MatveiMKS/Le-Dealos/README.md

# Le Dealos (projet arduino peip2)

## <ins>Cahier des charges</ins>

## I. <ins>Contexte et réalisation du problème</ins>
Lors de diverses soirées jeux de société durant lesquelles nous souhaitions jouer au BlackJack, nous avons été confrontés au problème de devoir sacrifier un joueur pour qu’il prenne le rôle du croupier.
Problème : Ne pas pas avoir de croupier dedié au BlackJack.

## II. <ins>Objectif et périmètre du projet</ins>
Réaliser un robot permettant de remplacer un croupier de BlackJack
Pour cela il devra pouvoir accomplir les tâches suivantes :
- Distribuer des cartes à un nombre donné de joueur (entre 1 et 4)
- Distribuer les cartes du croupier
- Lire la valeur de chaque carte distribuée
- Gérer la partie, le score et le gagnant
- Afficher les actions à effectuer
- Afficher le status de la partie

Fonctionnalités envisageables :
- Gérer le système de paris
- Ajouter des instructions vocales
- Un algorithme de poker
