MatveiMKS/Le-Dealos/Rapports séances/Maksimenka Matvei/rapport8.md

# Rapport de séance 8 du 21/02/2024

## Montage de l'écran
Cette séance ma principale mission était d'attacher l'écran et les boutons au projet.
Pour cela j'ai tout d'abord créé un designer a découper a la decoupe laser, mais je me suis trompé sur la manière de monter l'écran. Une fois un nouveau design conçu, j'ai pu le découper. Je comptais initialement monter la plaque à l'aide de coudes mais il n'y en avait que des trop gros. J'ai donc décidé de coincer la plaque entre les deux disques fixes entre lesquels se trouve toute l'électronique, mais le montage que j'avais prévu n'étais pas assez haut, je suis donc retourné sur inkscape et ai adapté la taille.

## Réhaussement de la plateforme
En prenant en compte tous les branchements nécessaires pour le projet je me suis rendu compte qu'il me faudra plus de place afin d'ajouter une plaque de distribution et faire passer plus de fils. J'ai donc ajouté des entretoises à chaque support et ai dû donc prendre de plus longue vis.

<p align="middle">
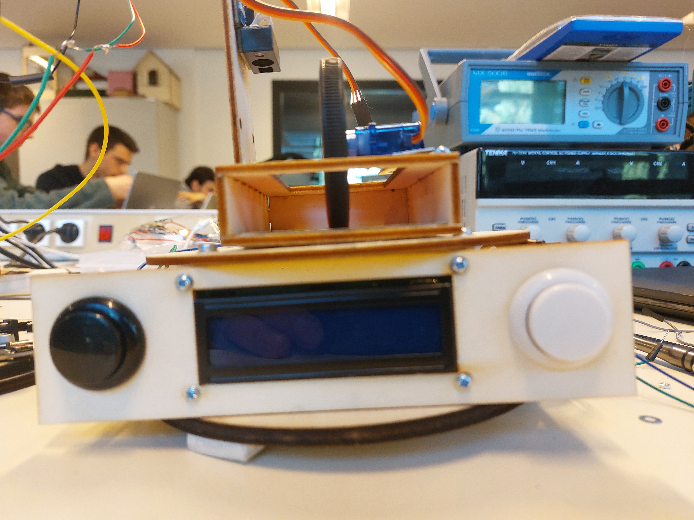
[picture p1: Images Diverses/ecran monte.jpg]
    
    
</p>
