MatveiMKS/Le-Dealos/Rapports séances/Maksimenka Matvei/rapports.md

# Rapport de séance du 14/02/24

## Changement de direction 
Nous avons reçus un nouveau capteur de QR code mais pour éviter le Burnout, nous avons échangé de tâches avec Théophile, je me suis donc mit au montage du projet.

En premier lieu j'ai collé deux patins en PVC sour le disque du dessus afin de pouvoir une mouvement circulaire fluide.

Ensuite j'ai monté l'arduino et le contrôleur pour le servo moteur sur le disque du dessus, pour cela je suis allé chercher des vis et boulons de la longueur nécessaire puis j'ai percé 8 trou dans le bois.

J'ai donc pu attacher les 2 cartes, pour que il n'y ait pas de câbles qui sortent sur les côtés je les ait fixé avec du gaffeur à l'intérieur.

Finalement j'ai pu tout mettre ensemble et ont voit enfin à quoi ça ressembler notre projet.

Je me suis aussi rendu compte que on n'allait pas avoir assez de sortie 5v et gnd j'ai donc soudé des fils ensemble pour faire des séparateurs.
