MatveiMKS/Le-Dealos/Rapports séances/Maksimenka Matvei/rapport6.md

# Rapport de séance 6 du 07/02/2024

## Les problèmes
Après la dernière séance où je n'ai pas réussit à faire fonctionner le qr code nous avons conclus que je l'qvais surement grillé en inversement les branchements. J'ai du donc faire la décision d'abandonner le travail sur le lecteur pour le moment on en commandera peut être un autre.

## La plateforme
J'ai décidé de continuer la séance en créant la plateforme surélevée qui contient la partie qui distribue les cartes. Je me suis d'abbord penché sur la manière de la hauteur. En m'inspirant du projet Robot de Surveillance j'ai pris de longues entretoises que j'ai vissé entre les deux plaques de bois. J'avais besoin de visses de +-10mm mais il n'y en avait plus j'ai du donc couper des vis de 20mm à la pince. J'ai enfin pu tout mettre ensemble et on commence à voir la forme entière du projet.

<p align="middle">
    
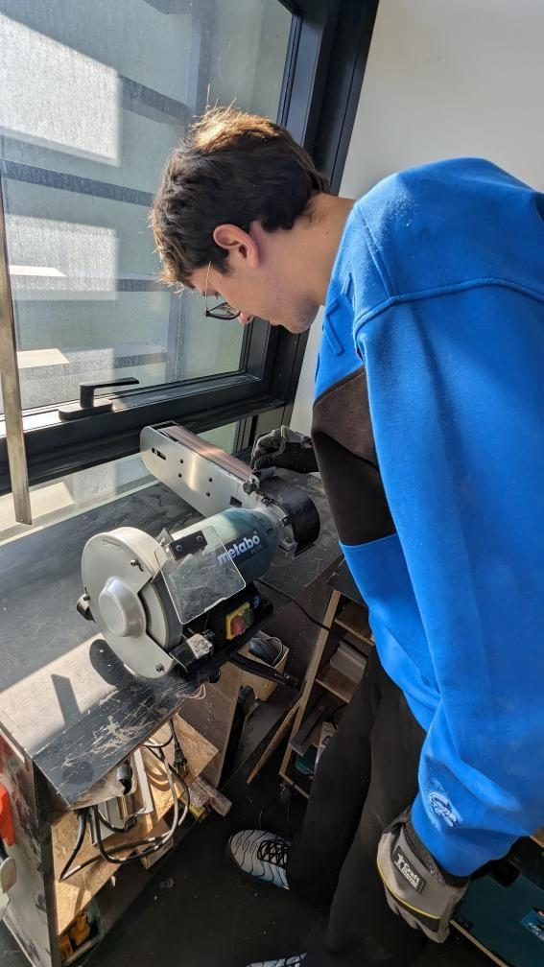
[picture p4: Images Diverses/cv te meuler.jpg]
    
</p>
