MatveiMKS/Le-Dealos/Rapports séances/Di Bona Théophile/rapport6.md

# Rapport de séance 6

## Finalisation du support rotatif 

J'ai finalement choisit d'opter pour la version du support rotatif avec un axe au milieu pour maintenir le tout.
J'ai commencer par réaliser une plaque ronde en bois pour fixer la roue cranté. J'ai percé le milieu de la plaque en bois pour y placer l'axe.

J'ai ensuite trouvé le milieu de la plaque sur laquelle est placé le moteur à l'aide d'un compas, puis j'ai percé celui-ci pour y faire passer l'axe 
J'ai assemblé le tout et lancé le tout et cela à fonctionné ! Enfin ! J'en ai profité pour visser le tout pour un fonctionnement optimal.

Cependant, le poids de la plaque faisait que l'extrémité à l'opposé du moteur touchait le roue cranté en plus de donné un rendu visuel moyen.
M Juan m'a donc proposé une tige de PVC dans laquelle j'ai pu découper quelques morceaux afin de m'en servir de calle et ainsi d'éviter le frottement.
J'ai collé ceux si sur la plaque de bois portant le moteur. Cela à bien fonctionner cependant j'ai perdu en fluidité de rotation. 

J'ai ensuite aidé Mateï pour le design de la plaque destiné à acceuillir les composants électroniques (carte arduino, driver, ....). Nous sommes parti du 
même modèle que les autre plaques rondes cependant nous avons prévu des emplacements pour le vis afin d'y placer des entretoises.
Nous avons monté le tout et nous sommes arrivé à ce resultats final.

## Objectifs pour la prochaine séance

Relier les boutons au tout, pour se rapprocher le plus possible de la fin de notre projet. Nous allons aussi commander un autre capteur car celui que nous avons est dysfonctionnel.
