MatveiMKS/Le-Dealos/Rapports séances/Di Bona Théophile/rapport5.md

# Rapport de séance 5

## Conception du support rotatif

Pour cette 4ème séance, j'ai commencé par finaliser mon esquisse 2D du sopport rotatif sur inskape. J'ai corrigé la taille de la fente prévue pour accueillir 
le moteur et réaliser deux trous de part et d'autres de la fente afin d'accueillir des vis permettant de fixer le moteur sur le contreplaqué.

Avant d'aller au FabLab pour réaliser la découpe, j'ai fait la démonstration et l'explication de notre projets aux lycéens venus pour découvrir notre école.
J'ai aussi profiter de ce temps pour répondre à leurs question sur l'école.

Une fois cette découpe réalisée, j'ai fixé mon moteur sur ce support à l'aide de vis et d'écrous que j'ai pu glisser dans les trous prévu à cet effet.
J'en ai aussi profité pour collé le pignon réaliser lors de la dernière séance au moteur pas à pas.

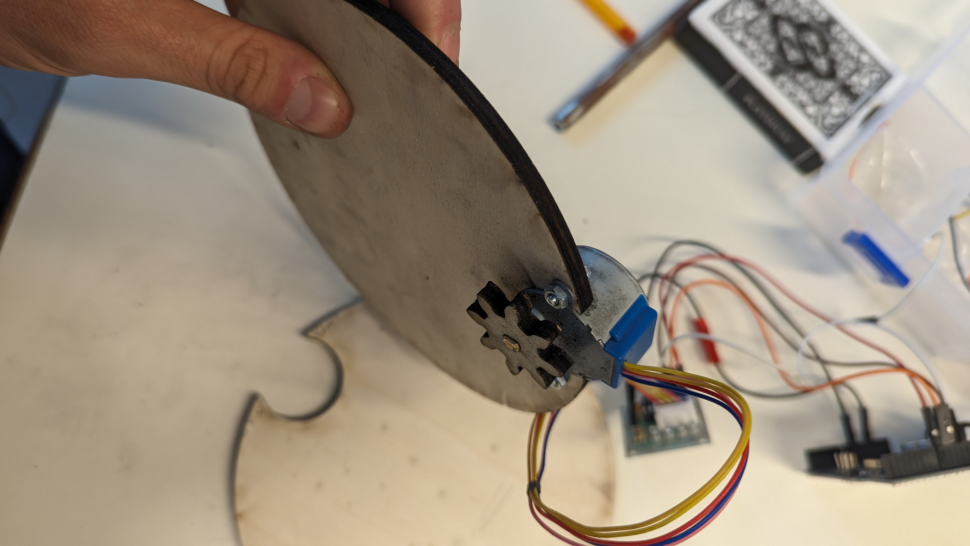
[picture p8: Images Diverses/fixation_moteur.jpg]


J'ai ensuite commencé l'assemblage du support rotatif et j'ai toute de suite fait face à un premier problème, celui-ci n'etait pas équilibré. 
J'ai donc tenté de mettre une punaise en-dessous du support pour le remettre à niveau cependant mon moteur deviait de sa trajectoire. J'ai donc 
réflechit à une autre option pour ajuster cela. J'ai choisit de réaliser un autre écrou qui serait fixé à l'opposé du moteur qui aurait pour fonction de 
bloquer la trajectoire de la partie rotative. J'ai donc réaliser un deuxième écrou avec un trou au milieu afin qu'il puisse acceuillir une tige autour de laquelle il tournerait. Encore une découpe au FabLaB pour ce deuxième écrou. J'ai ensuite été percer ma plaque rotative pour venir glisser la tige à l'intérieur.
J'ai tout assemblé mais malheureusement le moteur se bloquait comme s'il n'avait pas assez de couple pour entrainer ce 2ème écrou.

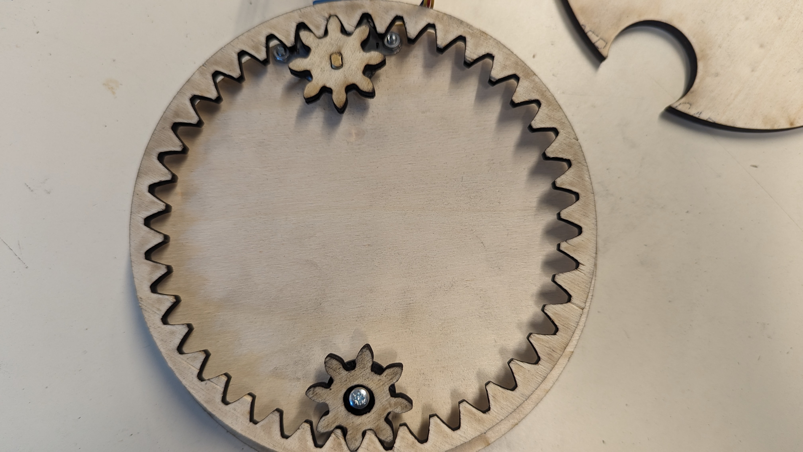
[picture p9: Images Diverses/rotation_double_pignon.jpg]


En 3ème option, j'ai choisit de mettre un axe métallique au milieu du support afin d'être sur que ça dévie pas de la trajectoire. Je pensais y placer un roulement à bille pour faciliter la rotation cependant après m'être concerter avec les professeurs un axe metallique seul devrait suffir.
Cependant, je n'ai pas le temps de réaliser cette dernière option.

## Bilan

Malheursement, j'ai encore peu avancé durant cette séance et je commence à prendre beaucoup de retard sur la conception du support rotatif. J'espère vraiment le finir durant la séance prochaine pour venir aider Matveï sur le lecteur de QR code. Quitte à change de système avec un engrenage placé à l'extérieur du système.
Malgré le fait que cet option est bien moins ergonomique.
