MatveiMKS/Le-Dealos/Rapports séances/Di Bona Théophile/rapport4.md

# Rapport de scéance 4

## Réalisation du support rotatif 

J'ai commencé cette séance par étudier le fonctionnement du moteur pas à pas puis réaliser un programme afin de faire fonctionner le moteur

J'ai ensuite modélisé un nouvel engrenage afin de pouvoir le fixer sur le moteur car celui que j'avais réaliser précedemment n'était pas adapté. 
Puis j'ai été le découper au Fab Lab mon engrenage dans du contreplaqué de 5mm. J'ai réaliser les premiers test avec la roue crantée fabriqué lors de la 
séance précédente. Cela fonctionnait bien cependant j'ai peur qu'une fois le système fini le couple ne soit pas assez puissant pour faire tourner tout le système.

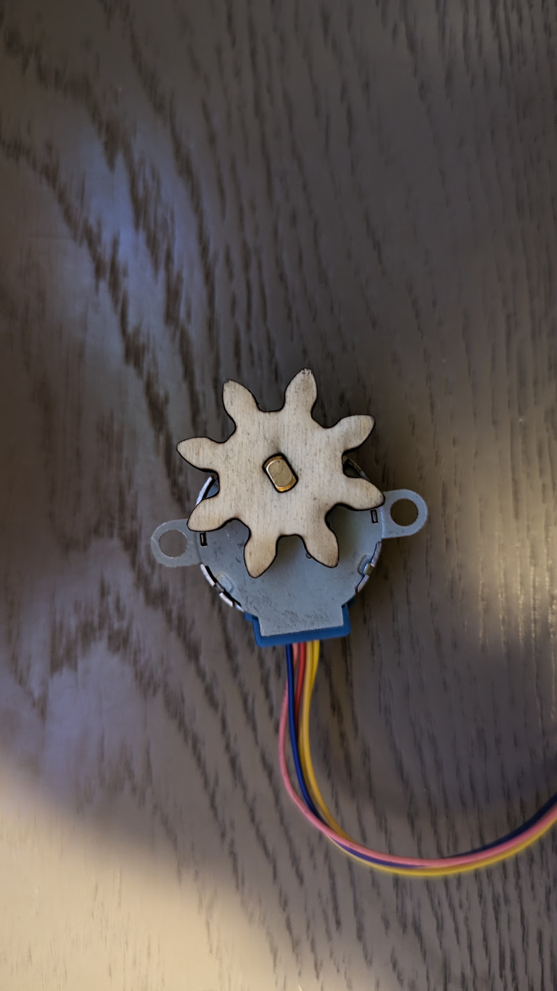
[picture p10: Images Diverses/moteur_engrenage.jpg]


J'ai ensuite réaliser sur inkscape la pièce qui prendra place au dessus du moteur sur laquelle tout le reste du système sera placé.
Pour cela j'ai tracé un cercle du diamètre de la roue crantée avec un creux en arc de cercle sur une extrémité pour venir accueillir le moteur.

J'ai ensuité été découper cette pièce au Fab Lab dans du contre plaqué de 5mm. Malheureusement au moins d'agrandir mon cercle je n'ai pas conservé la taille de 
l'encoche pour le moteur. Donc au moment d'assembler les pièces, les trous permettant de fixer le moteur étaient dans le vide. J'ai donc du réaliser une autre 
pièce dans les bonnes dimension. J'en ai aussi profiter pour faire les trous pour les vis pour ne pas avoir à repercer dans le contreplaquer et risquer de briser le bois.

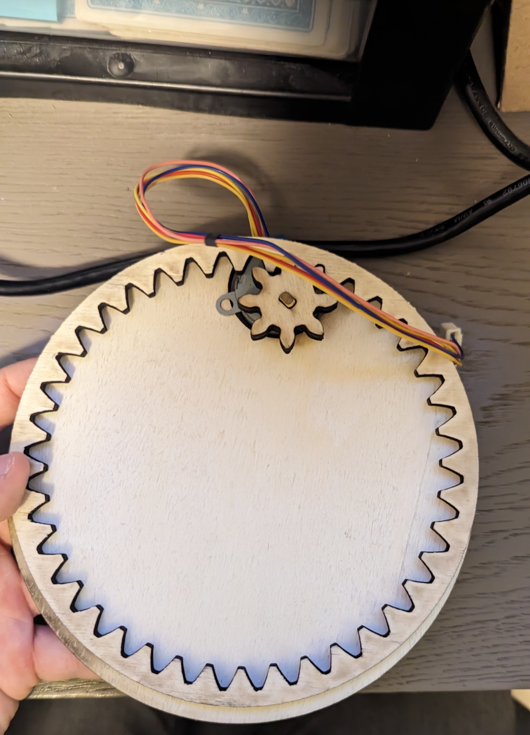
[picture p11: Images Diverses/systeme_rotatif_v1.jpg]


## Objectif pour la semaine prochaine 

Finir le support rotatif et débuter la lecture des QR codes.
