MatveiMKS/Le-Dealos/Rapports séances/Maksimenka Matvei/rapport4.md

# Rapport de séance 4 du 17/01/2024

## Interaction homme machine (suite)
Durant cette séance j'ai pris le temps de revoir mon code afin de le rendre plus clair et robuste en enlevant des tests et boucles inutiles.
J'ai ensuite commencé à créer le jeu lui-même, pour cela je fait distribuer deux cartes a tout les joueurs et au croupier.
J'ai ensuite fait des recherches afin d'implémenter la possibilité pour le programme de savoir qui a gagné en considérant les cartes de tous les joueurs. Pour cela je suis d'abord parti sur la piste d'un dictionnaire ou les clés seraient les joueurs et les valeurs leurs cartes mais cela paraissait trop compliqué sur arduino car cela occupe trop de place sur l'arduino.
Je vais donc plutôt créer une liste de liste avec 4 éléments car il y a au maximum 4 joueurs.

Malheureusement je n'ai pas de photos pour cette séance car il n'y avait pas grand chose à montrer. Je suis tout de même content car je vois que le code est bien avancé.
