MatveiMKS/Le-Dealos/Rapports séances/Di Bona Théophile/rapport3.md

# Rapport de séance 3

## Réalisation du support rotatif 

J'ai commencé la séance par me questionner quant à la réalisation du support rotatif. J'ai opté pour un système d'engrenage qui serait placé en-dessous 
le système de distribution. Il y aurait une grande roue dentée ouverte fixe dans laquelle une autre roue denté entrainée par un moteur tournerait à l'intérieur
de cette roue pour faire tourner tout le système.

Cependant, j'ai perdu beaucoup de temps sur la réalisation de ces engrenages. En effet, presque aucun logiciel ne propose une aide à la modélisation en 3 dimension
pour ce type d'engrenage. J'ai finalement trouvé un site web permettant de les modéliser et de les exporter au format SVG. J'ai donc voulu dans un premier temps 
importer ce fichier SVG dans OnShape (Logiciel de modélisation 3D) comme esquisse pour ensuite l'extruder. Au final, après concertation avec les encadrants,
j'ai choisis de réaliser ces engrenages en bois.

J'ai donc adaptée la roue motrice afin de pouvoir la fixer au moteur. Puis j'ai découpé ces engrenages dans une plaque de bois de 5mm. J'ai poncé l'exterieur de 
la roue fixe pour un meilleur rendu. Puis j'ai collé la rondelle fournie dans la boite du moteur sur le petit engrenage.

J'ai ensuite réaliser un programme pour voir si ce système fonctionnait. Cependant le servo-moteur qui nous avait été fourni n'était pas à rotation continue
il pouvait seulement tourner sur un angle de 270°. J'ai donc demandé un autre moteur à rotation continue cependant celui qui m'a été donné pouvait seulement 
effectuer une rotation de 180°. 

Pour la prochaine séance, prendrais un moteur pas à pas cela sera plus simple, n'utilisant les autres fonctions du servo-moteur

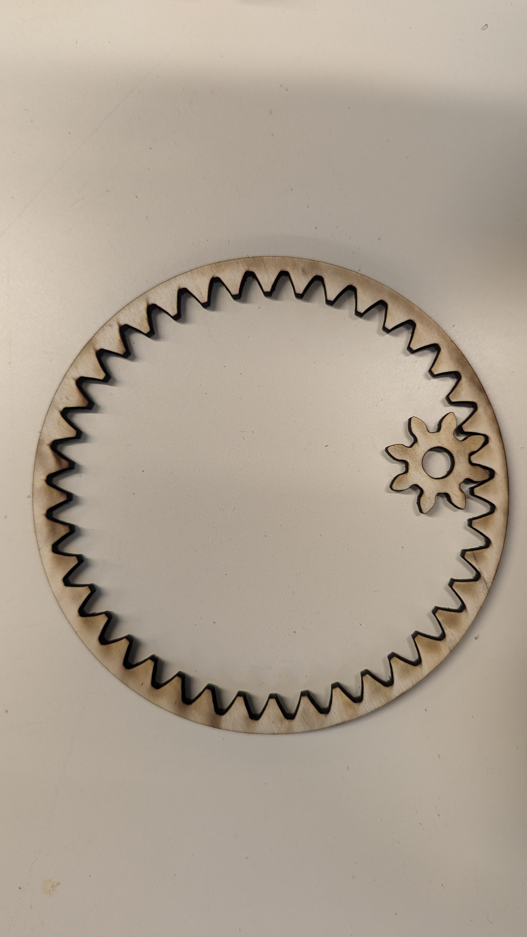
[picture p13: Images Diverses/engrenage_support.jpg]
support


## Bilan 

J'ai peu avancé durant cette séance, j'espère pouvoir être plus productif durant la prochaine séance et finir si possible le support
