MatveiMKS/Le-Dealos/Rapports séances/Maksimenka Matvei/rapport2.md

# Rapport de séance 2 du 20/12/2023

## Branchement des 4 boutons
J'ai pu cette semaine faire le branchement des 4 boutons dont on aura besoin pour interagir avec notre robot.
<p align="middle">
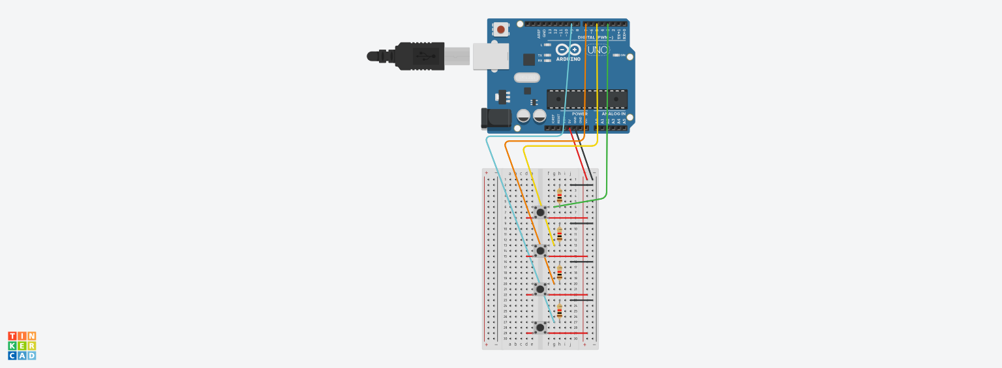
[picture p14: Images Diverses/boutons montage.png]
    
     
</p>

## Code pour les boutons
Je me suis ensuite occupé du code qui détecte quel bouton a été appuyé en dernier et fait en sorte qu'on ait plus qu'à ajouter sa fonction (simulé par l'affichage du mot action).

<p align="middle">
    
     
</p>
<p align="middle">
    <a>Demande d'interaction</a>
    <a>-------------------</a>
    <a>Affichage de l'action</a>
</p>

## Conclusion de la séance
J'ai maintenant la base qui me permettra de piloter tout le projet, il faut maintenant que je relie le code a la partie de Théophile afin que l'on puisse se faire distribuer une carte en appuyant sur un bouton.
