MatveiMKS/Le-Dealos/Rapports séances/Di Bona Théophile/rapport2.md

# Rapport de séance 2

## Creation du support de carte 

J'ai commencé cette séance par découper sur une plaque de bois de 3mm le support pour les cartes.

J'ai agrandi le creux sur la surface haute de la boite afin de m'assurer que le lecteur de code bar puisse lire la valeur de la carte.

Une fois le support découpé je l'ai assemblé puis collé avec de colle à bois pour assurer une meilleur rigidité. J'ai donc obtenu le résultat suivant :

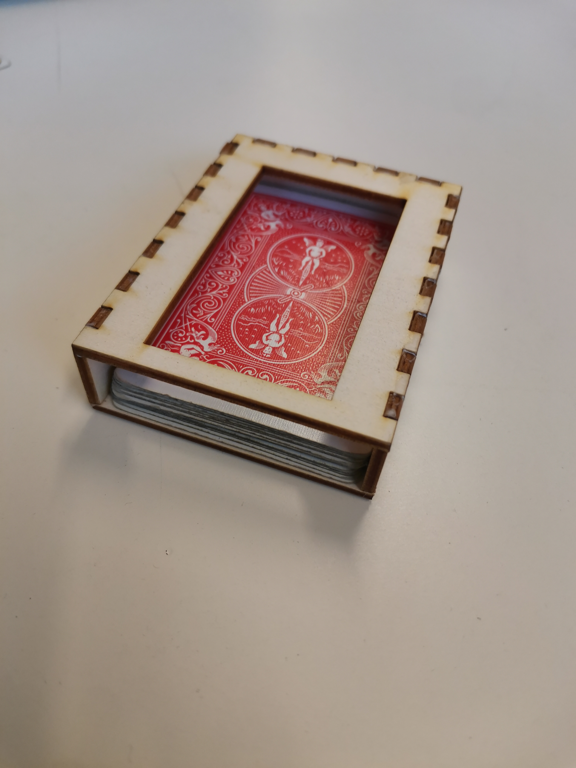
[picture p15: Images Diverses/support_carte_assemble.jpg]
support


## Ajout du moteur sur le support 
Puis j'ai réflechis et comparé les différents système pour la fixation du moteur sur le support. J'ai finalement opté pour un système de charnière fixé sur le 
coté du support. Le moteur se colle au carte grâce à son poids et descend petit à petit au fur et à mesure que les cartes sont distribuées.
Le bois du support étant peu épais, j'ai fixé la charnière au support et le moteur à la charnière à l'aide d'un pisolet à colle.

J'ai ensuite adapté les temps et puissance de moteur sur le programme arduino afin de ne distribuer qu'une seule carte à la fois. 
J'obtiens donc le resultat suivant : 

fonctionnement

Parfois deux cartes sont à distribuées en une seule fois, je pense que cela est lié au fait que les cartes ne sont pas plastifiées donc celle-ci s'accrochent 
entre elles. Nous opterons ainsi pour une jeu de bicycle plastifié comme ceux utilisé en magie ou au poker.

Sur cette fin de séance, nous avons essayer de lier nos travaux avec Matveï de façon à ce qu'une carte soit distribuée lorsque l'on appuie sur le bouton "Tirer".
Cependant cela à causé de nombreux bugs, l'écran ne s'allumait pas et le moteur ne fonctionnait pas non plus. Cela est surement dû au fait que nous étions en fin de séance et nous n'avons pas pris le temps de bien faire les branchements. Nous allons donc profiter des vacances pour faire cela !

En conclusion, j'ai réussi à accomplir le premier objecif sur le temps que nous nous étions donné. 

## Objectif pour la séance suivante
Ayant fini cette première partie, je vais pouvoir me lancer sur l'affichage écran des différents statuts de jeux. Etant donné que les écrans LCD semblent petit peut être utiliser un écran plus grand.
