MatveiMKS/Le-Dealos/Rapports séances/Maksimenka Matvei/rapport1.md

# Rapport de séance 1 du 13/12/2023

## Résolution de problème d'IDE
Lors du démarrage du projet, je me suis rendu compte que mon IDE était mal installé et nous  n'avons pas trouvé de solution je serais donc obligé d'aller visiter le bureau de 
Sans moyen d'utiliser ma carte arduino je suis obligé de passer au prototypage.

## Soudure des boutons
Les bontons n'ayant pas de fils au bout, j'ait soudé des fils avec des embouts males pour les connecter sur l'Arduino. Je les ait ensuite testés pour vérifier que j'ai bien soudé pour enfin mettre du gaffeur pour eviter les courts circuits ou que les soudures cassent.

<p align="middle">
    
     
</p>
<p align="middle">
    <a>Soudure d'un bouton</a>
    <a>-------------------</a>
    <a>Test de l'un des boutons</a>
</p>

## Conclusion de la séance
Je n'ai malheureusement pas pu avancer aussi loin que je voulais en raisons de mes problèmes ordinateur qui ne sont tout de même pas résolus, j'espère rattraper le rythme a la prochaine séance.
