MatveiMKS/Le-Dealos/Rapports séances/Di Bona Théophile/rapport1.md

# Rapport de séance 1
## Creation du support de carte 
Creation d'une boite sur Makercase aux dimension d'un paquet de carte Bicycle classique.

Edition de la face du haut de cette boite à l'aide du logiciel Inkscape.

La fente créée permettra que la roue soit en contact avec les cartes 
afin de les distribuer. 

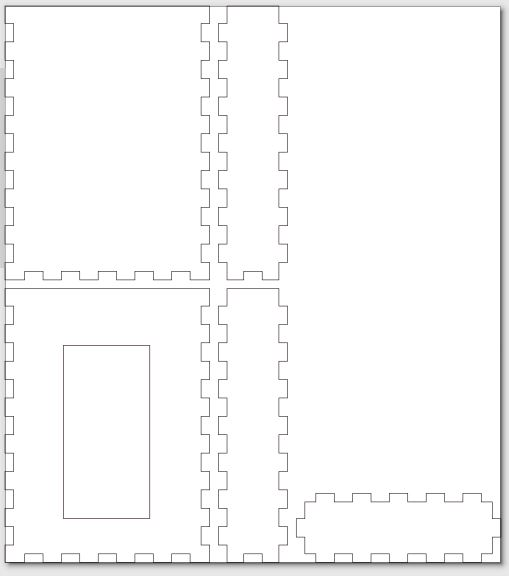
[picture p18: Images Diverses/capture_support_carte.JPG]
Plan de découpe


Nous pourrons réaliser la découpe la semaine prochaine.

## Essai et création d'une programme pour le Servomoteur SG90
Réalisation d'un programme permettant de distribuer une carte à la fois.

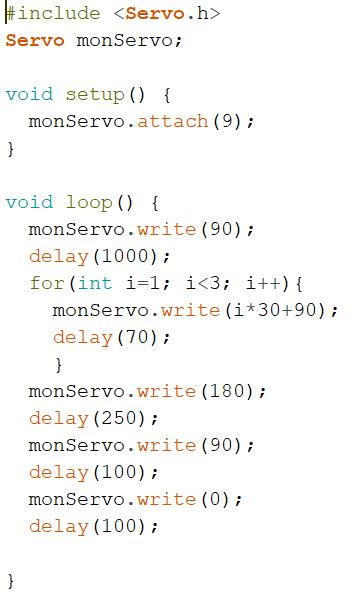
[picture p19: Images Diverses/programme_distribution_v1.JPG]
Programme distribution

Première tentative distribution de carte


J'ai constaté qu'il va être compliqué de gérer la pression de la roue sur les cartes.

Nous allons donc devoir utiliser un élastique ou bien un ressort pour adapter la pression en fonction du nombre de cartes restantes.

Cela m'a aussi fait me questionner sur l'idée d'agrandir la fente car lorsque la roue est positionnée sur l'avant de la carte,

la distribution des cartes une par une 
est mieux gérée. De plus les cartes vont plus loins.

Nous pensons aussi qu'il faudra rajouter une petit rampe pour faire en sorte que les cartes aillent plus loin.  
lien d'une image

## Objectif pour la semaine suivante 
Réaliser la découpe laser du support 

Réaliser le montage du système moteur et support 

  Sytème de charnière pour faire le tenir le moteur equipé d'un ressort pour maintenir une pression constante
