MatveiMKS/Le-Dealos/Rapports séances/Di Bona Théophile/rapport0.md

# Rapport de séance 0

## Tâche effectuée
Description de la tâche

lien d'une image
