MatveiMKS/Le-Dealos/(commit log)

2023-12-13 ajt les objectifs au rapport
2023-12-20 support carte assemblé
