MatveiMKS/Le-Dealos/Images Diverses/ecran arriere.jpg

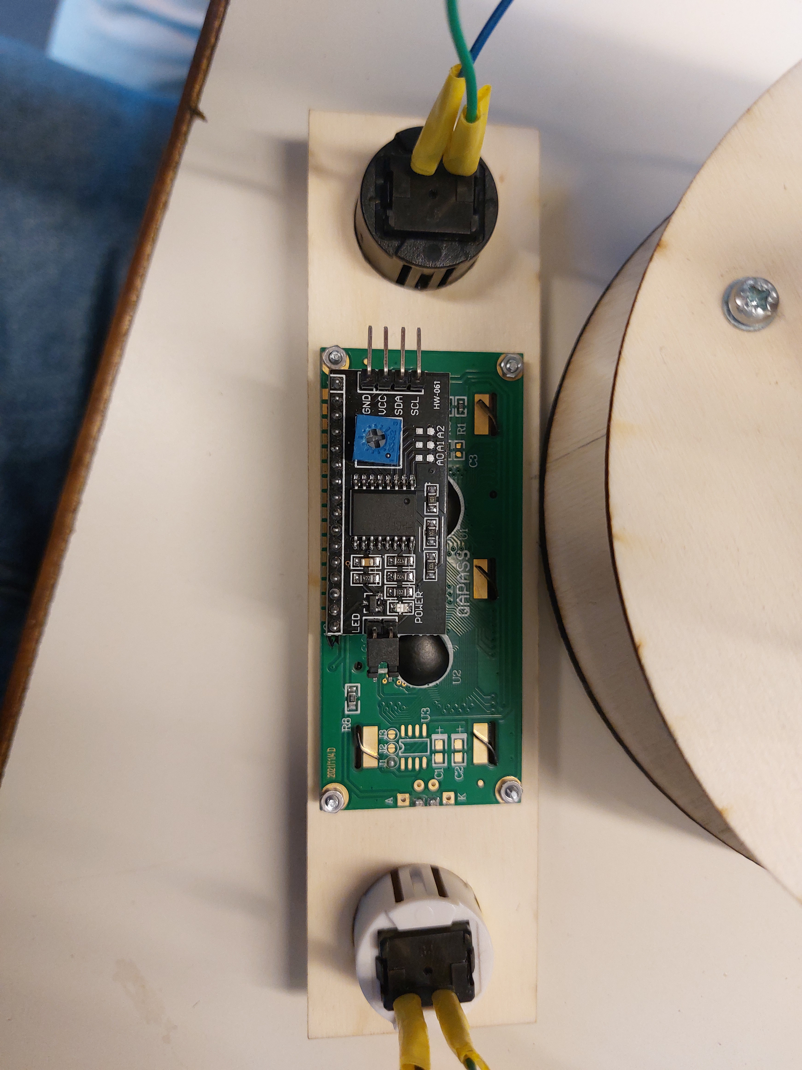
[picture p2: Images Diverses/ecran arriere.jpg]
Images Diverses/ecran arriere.jpg
