MatveiMKS/Le-Dealos/Images Diverses/2 plaques.jpg

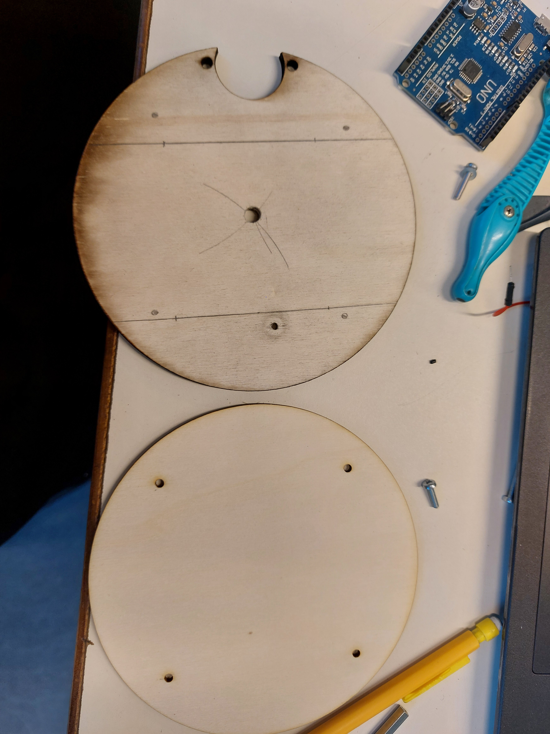
[picture p3: Images Diverses/2 plaques.jpg]
Images Diverses/2 plaques.jpg
