MatveiMKS/Le-Dealos/Images Diverses/soudure lecteur.jpg

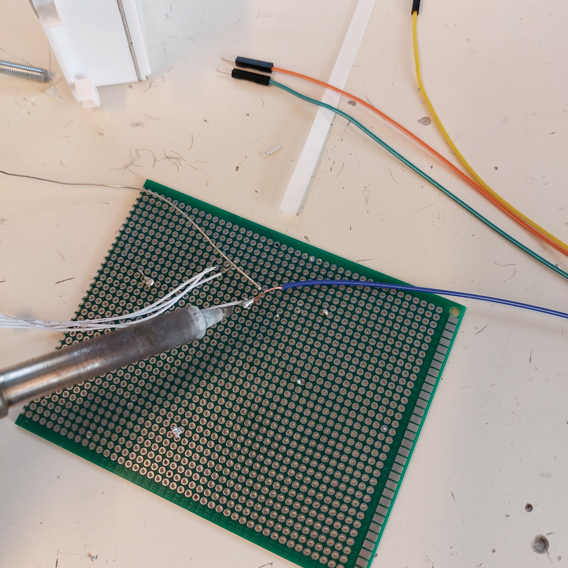
[picture p5: Images Diverses/soudure lecteur.jpg]
Images Diverses/soudure lecteur.jpg
