MatveiMKS/Le-Dealos/Images Diverses/20231213_115449.jpg

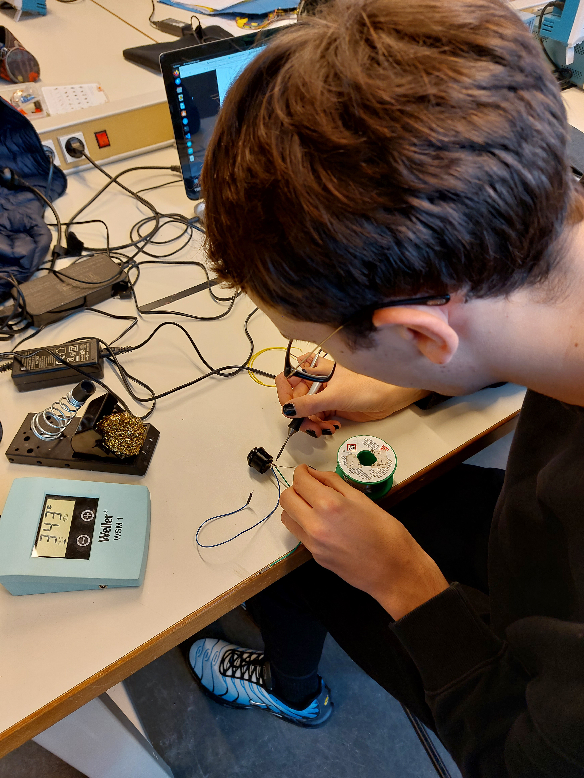
[picture p16: Images Diverses/20231213_115449.jpg]
Images Diverses/20231213_115449.jpg
