MatveiMKS/Le-Dealos/Images Diverses/20231213_121834.jpg

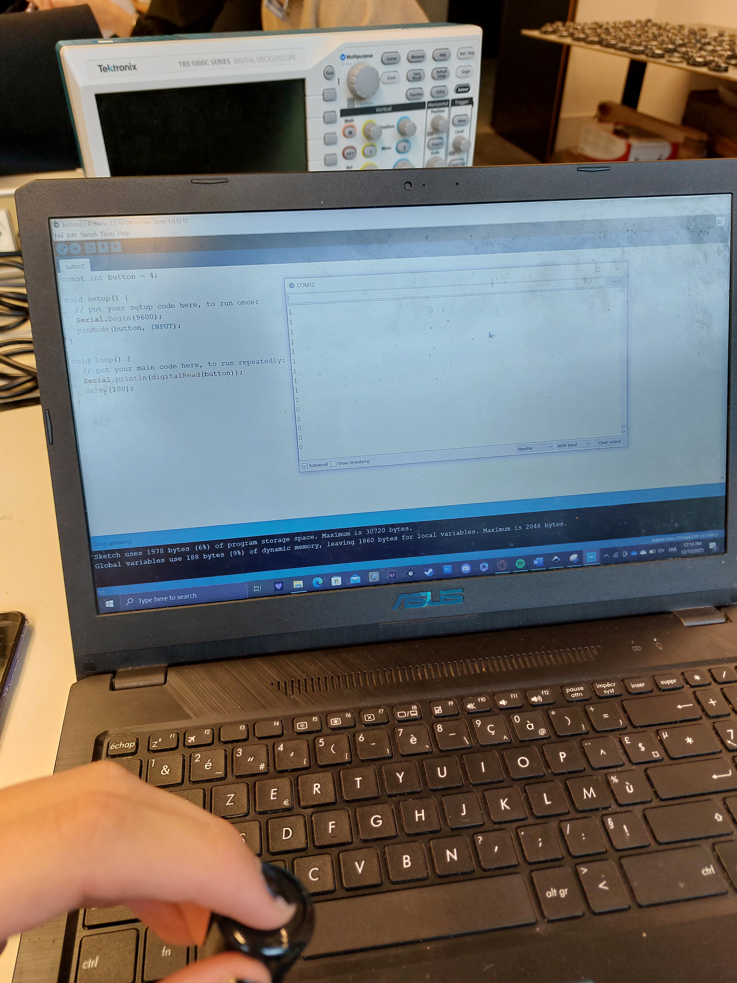
[picture p17: Images Diverses/20231213_121834.jpg]
Images Diverses/20231213_121834.jpg
