MatveiMKS/Le-Dealos/Images Diverses/20231213_123433.jpg

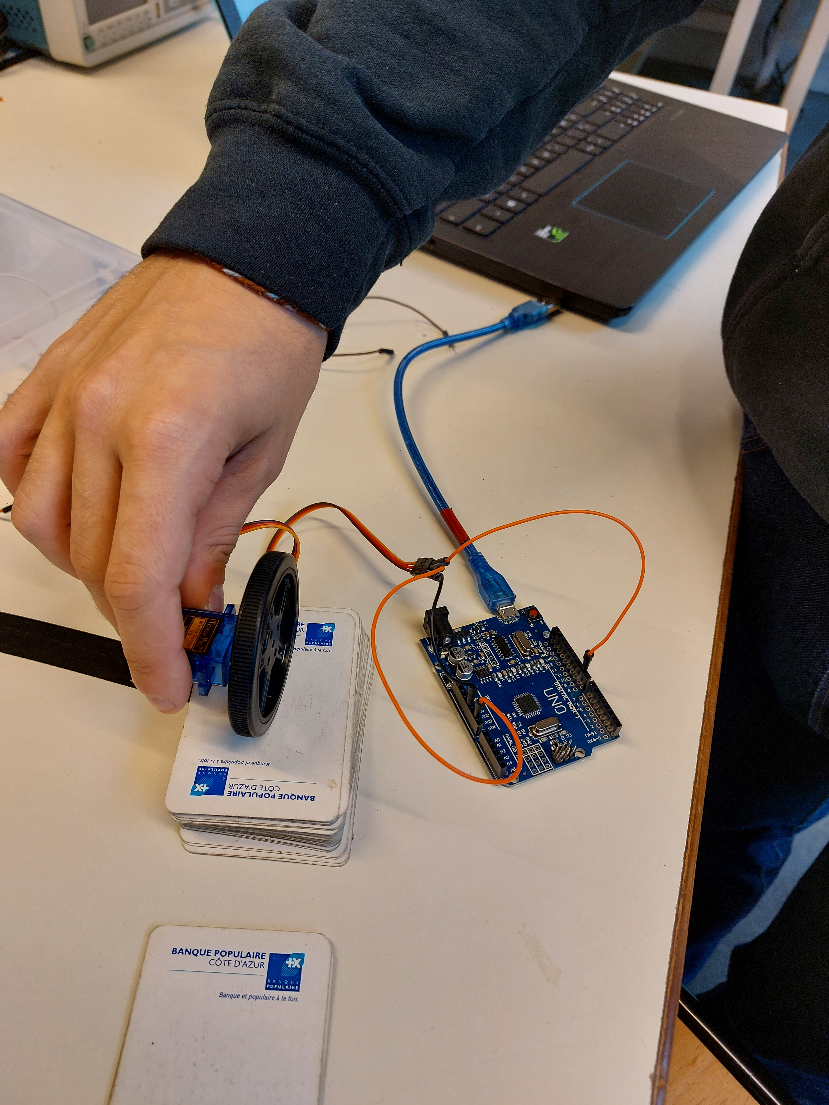
[picture p20: Images Diverses/20231213_123433.jpg]
Images Diverses/20231213_123433.jpg
