MatveiMKS/Le-Dealos/Images Diverses/20231213_121844.jpg

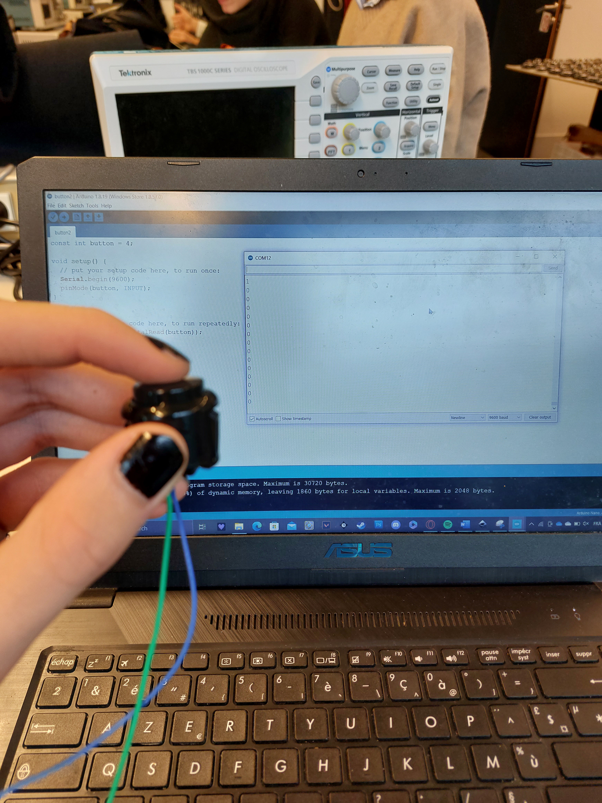
Images Diverses/20231213_121844.jpg
