MatveiMKS/Le-Dealos/Images Diverses/20231213_121849.jpg

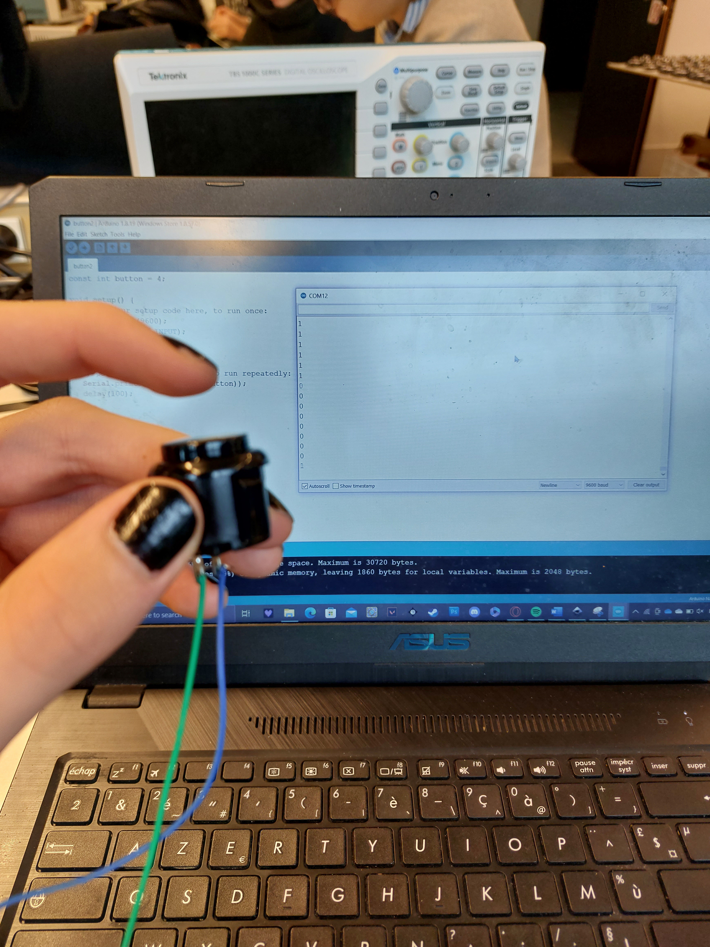
Images Diverses/20231213_121849.jpg
